CPSLO-AI-Campus-Fire-Detection/senseboard/Senseboard BOM.xlsx

Sheet: senseboard
Value | Reference | Footprint | JLCPCB Part # | Qty | MFR | PN | DNP
DNP | AE1 | Connector_Coaxial:SMA_Molex_73251-1153_EdgeMount_Horizontal | DNP | 1 | Molex | 732511153 | DNP
DNP | BT1 | Battery:BatteryHolder_Keystone_1057_1x2032 | DNP | 1 | Keystone Electronics | 1057
4.7uF | C1,C2,C5 | Capacitor_SMD:C_0805_2012Metric | C1779 | 3 | Samsung Electro-Mechanics | CL21A475KAQNNNE
10nF | C3,C23 | Capacitor_SMD:C_0402_1005Metric | C327009 | 2 | Murata Electronics | GRM155R71C103KA01D
0.1uF | C4,C8,C13,C14,C15,C16,C17,C18,C21,C22,C25,C26,C33 | Capacitor_SMD:C_0402_1005Metric | C133086 | 13 | Samsung Electro-Mechanics | CL05B104KP5NNNC
10uF | C6,C7,C34,C36 | Capacitor_SMD:C_0805_2012Metric | C1713 | 4 | Samsung Electro-Mechanics | CL21A106KOQNNNE
1uF | C9,C10,C11,C12,C24 | Capacitor_SMD:C_0603_1608Metric | C29936 | 5 | Samsung Electro-Mechanics | CL10B105KA8NNNC
4.7uF | C19,C20,C35,C37,C38 | Capacitor_SMD:C_0603_1608Metric | C1705 | 5 | Samsung Electro-Mechanics | CL10A475KP8NNNC
DNP | C27 | Capacitor_SMD:C_0603_1608Metric |  | 1 | KEMET | C0603C104K3RACTU | DNP
DNP | C28 | Capacitor_SMD:C_0805_2012Metric |  | 1 | Samsung Electro-Mechanics | CL21A475KAQNNNE | DNP
DNP | C29,C30 | Capacitor_SMD:C_0402_1005Metric |  | 2 |  |  | DNP
7pF | C31,C32 | Capacitor_SMD:C_0402_1005Metric | C161333 | 2 | Murata Electronics | GRM1555C1H7R0CA01D
STPS120MF | D1,D3 | Diode_SMD:D_SMP_DO-220AA | C2927425 | 2 | STMicroelectronics | STPS120MF
STPS1L30A | D2,D4 | Diode_SMD:D_SMA | C157388 | 2 | STMicroelectronics | STPS1L30A
LED | D5 | LED_SMD:LED_0402_1005Metric | C364556 | 1 | Lite-On Inc. | LTST-C281KRKT
BAT54WX-TP | D6,D7 | Diode_SMD:D_SOD-523 | C283259 | 2 | MCC (Micro Commercial Components) | BAT54WX-TP
Polyfuse | F1 | Fuse:Fuse_0805_2012Metric | C5220829 | 1 | Bel Fuse Inc. | 0ZCK0050FF2E
FerriteBead | FB1 | Inductor_SMD:L_0603_1608Metric | C107335 | 1 | TDK | MPZ1608S601ATA00
USB_C_Receptacle_USB2.0_16P | J1 | Connector_USB:USB_C_Receptacle_G-Switch_GT-USB-7010ASV | C2988369 | 1 | G-Switch | GT-USB-7010ASV
DNP | J2 | Connector_JST:JST_XH_B2B-XH-AM_1x02_P2.50mm_Vertical |  | 1 | JST Sales America Inc. | B2B-XH-AM | DNP
DM3AT-SF-PEJM5 | J3 | DM3AT_SF_PEJM5:HRS_DM3AT-SF-PEJM5 | C114218 | 1 | Hirose Electric Co Ltd | DM3AT-SF-PEJM5
DNP | J4 | Connector_PinHeader_2.54mm:PinHeader_1x04_P2.54mm_Vertical |  | 1 |  |  | DNP
DNP | J5 | Connector_PinHeader_2.54mm:PinHeader_1x08_P2.54mm_Vertical |  | 1 |  |  | DNP
2.2uH | L1,L2 | Inductor_SMD:L_Murata_DFE201610P | C337893 | 2 | Murata Electronics | DFE201612E-2R2M=P2
10k | R1,R9,R11,R18,R19 | Resistor_SMD:R_0402_1005Metric | C60490 | 5 | YAGEO | RC0402FR-0710KL
5.1k | R2,R3 | Resistor_SMD:R_0402_1005Metric | C278598 | 2 | Panasonic Industry | ERJ-2RKF5101X
0 | R4,R5,R6,R7,R8,R10,R20,R28,R31,R33 | Resistor_SMD:R_0402_1005Metric | C60485 | 10 | YAGEO | RC0402JR-070RL
100k | R12,R13,R14 | Resistor_SMD:R_0402_1005Metric | C60491 | 3 | YAGEO | RC0402FR-07100KL
4.7 | R16,R17 | Resistor_SMD:R_0603_1608Metric | C5549523 | 2 | YAGEO | RC0603FR-134R7L
330 | R21 | Resistor_SMD:R_0402_1005Metric | C226996 | 1 | YAGEO | AC0402FR-07330RL
47k | R22,R23,R24,R25,R26,R27 | Resistor_SMD:R_0402_1005Metric | C728561 | 6 | YAGEO | RT0402BRD0747KL
DNP | R29,R32 | Resistor_SMD:R_0402_1005Metric |  | 2 | YAGEO | RC0402JR-070RL | DNP
330 | R30 | Resistor_SMD:R_0603_1608Metric | C105881 | 1 | YAGEO | RC0603FR-07330RL
USBLC6-2SC6 | U1 | Package_TO_SOT_SMD:SOT-23-6 | C7519 | 1 | STMicroelectronics | USBLC6-2SC6
TPS62849DLCR | U2,U3 | TPS62849DLCR:VSON8_2P1X1P6_TEX | C2071003 | 2 | Texas Instruments | TPS62849DLCR
SCD41-D-R2 | U4 | Sensor:Sensirion_SCD4x-1EP_10.1x10.1mm_P1.25mm_EP4.8x4.8mm | C3659294 | 1 | Sensirion AG | SCD41-D-R2
SGP41-D-R4 | U5,U6 | SGP41-D-R4:XDCR_SGP41-D-R4 | C3659325 | 2 | Sensirion AG | SGP41-D-R4
SHT4x | U7 | Sensor_Humidity:Sensirion_DFN-4_1.5x1.5mm_P0.8mm_SHT4x_NoCentralPad | C7461863 | 1 | Sensirion AG | SHT41A-FD1B-R2
STM32L4Q5CGUx | U8 | Package_DFN_QFN:QFN-48-1EP_7x7mm_P0.5mm_EP5.6x5.6mm | C2970026 | 1 | STMicroelectronics | STM32L4P5CGU6
DNP | U9 | RF_Module:HOPERF_RFM9XW_SMD |  | 1 | RF Solutions | RFM95W-915S2 | DNP
EMIF06-MSD02N16 | U10 | EMIF06_MSD02N16:MICROQFN16_1P25X3P55X0P4_STM | C5267594 | 1 | STMicroelectronics | EMIF06-MSD02N16
BME690 | U11 | BME690:BME690 | C42431867 | 1 | Bosch Sensortec | BME690
Crystal_GND3 | Y1 | Crystal:Resonator_SMD_Murata_CSTxExxV-3Pin_3.0x1.1mm | C341520 | 1 | Murata Electronics | CSTNE12M0G550000R0
Crystal | Y2 | Crystal:Crystal_SMD_EuroQuartz_EQ161-2Pin_3.2x1.5mm | C276424 | 1 | Abracon LLC | ABS07-32.768KHZ-7-T

Sheet: Senseboard 1 r0
Reference | Qty | Value | Footprint | MPN | Datasheet Link
AE1 | 1 | Antenna_Shield |  | 732511153
BT1 | 1 | Battery_Cell |  | 1057
C1,C2,C5,C19,C20 | 5 | 4.7uF
C3,C22 | 2 | 10nF
C4 | 1 | 100nF
C6,C7 | 2 | 10uF
C8,C9,C14,C15,C16,C17,C18,C21,C24 | 9 | 0.1uF
C10,C11,C12,C13,C23 | 5 | 1uF
D1,D2,D3,D4 | 4 | PMEG1020EA |  | STPS1L30MF
F1 | 1 | Polyfuse |  | 0ZCK0050FF2E
FB1 | 1 | FerriteBead |  | MPZ1608S601ATA00
J1 | 1 | USB_C_Receptacle_USB2.0_16P |  | GT-USB-7010ASV
J2 | 1 | Micro_SD_Card_Det1 |  | DM3AT-SF-PEJM5
L1,L2 | 2 | 2.2uH |  | DFE201612E-2R2M=P2
R1,R4,R5,R6,R7,R17,R18,R19,R20,R21,R22 | 11 | 0
R2,R3,R8 | 3 | 5.1k
R9,R10,R11,R12,R15,R23,R24,R25,R26 | 9 | 10k
R13,R14 | 2 | 4.7
R16 | 1 | TBD
SW1 | 1 | SW_Push
U1 | 1 | USBLC6-2SC6 | Package_TO_SOT_SMD:SOT-23-6 | USBLC6-2SC6
U2,U3 | 2 | TPS62840DLCR | TPS62840DLCR:VSON8_2P1X1P6_TEX | TPS62849DLCR
U4 | 1 | SCD41-D-R2 | Sensor:Sensirion_SCD4x-1EP_10.1x10.1mm_P1.25mm_EP4.8x4.8mm
U5,U6 | 2 | SGP41-D-R4 | SGP41-D-R4:XDCR_SGP41-D-R4
U7 | 1 | SHT4x | Sensor_Humidity:Sensirion_DFN-4_1.5x1.5mm_P0.8mm_SHT4x_NoCentralPad
U8 | 1 | STM32L4Q5CGUx | Package_DFN_QFN:QFN-48-1EP_7x7mm_P0.5mm_EP5.6x5.6mm
U9 | 1 | RFM95W-915S2
Y1 | 1 | Crystal_GND3

Sheet: senseboard r1
Reference | Value | Datasheet | Footprint | Qty | MFR | PN | DNP
AE1 | Antenna_Shield |  | Connector_Coaxial:SMA_Molex_73251-1153_EdgeMount_Horizontal | 1 | Molex | 732511153
BT1 | CR2032 |  | Battery:BatteryHolder_Keystone_1057_1x2032 | 1 | Keystone Electronics | 1057
C1,C2,C5 | 4.7uF |  | Capacitor_SMD:C_0805_2012Metric | 3 | Samsung Electro-Mechanics | CL21A475KAQNNNE
C3,C23 | 10nF |  | Capacitor_SMD:C_0402_1005Metric | 2 | Murata Electronics | GRM155R71C103KA01D
C6,C7 | 10uF |  | Capacitor_SMD:C_0805_2012Metric | 2 | Samsung Electro-Mechanics | CL21A106KOQNNNE
C4, C8,C13,C14,C15,C16,C17,C18,C21,C22,C25,C26 | 0.1uF |  | Capacitor_SMD:C_0402_1005Metric | 12 | Samsung Electro-Mechanics | CL05B104KP5NNNC
C9,C10,C11,C12,C24 | 1uF |  | Capacitor_SMD:C_0603_1608Metric | 5 | Samsung Electro-Mechanics | CL10B105KA8NNNC
C19,C20 | 4.7uF |  | Capacitor_SMD:C_0603_1608Metric | 2 | Samsung Electro-Mechanics | CL10A475KP8NNNC
C27 | 0.1uF |  | Capacitor_SMD:C_0603_1608Metric | 1 | KEMET | C0603C104K3RACTU | DNP
C28 | 1uF |  | Capacitor_SMD:C_0805_2012Metric | 1 | Samsung Electro-Mechanics | CL21B105KAFNNNE | DNP
D1,D2,D3,D4 | PMEG1020EA |  | Diode_SMD:D_SMP_DO-220AA | 4 | STMicroelectronics | STPS1L30MF
D5 | LED |  | LED_SMD:LED_0402_1005Metric | 1 | Lite-On Inc. | LTST-C281KRKT
F1 | Polyfuse |  | Fuse:Fuse_0805_2012Metric | 1 | Bel Fuse Inc. | 0ZCK0050FF2E
FB1 | FerriteBead |  | Inductor_SMD:L_0603_1608Metric | 1 | TDK | MPZ1608S601ATA00
J1 | USB_C_Receptacle_USB2.0_16P | https://www.usb.org/sites/default/files/documents/usb_type-c.zip | Connector_USB:USB_C_Receptacle_G-Switch_GT-USB-7010ASV | 1 | G-Switch | GT-USB-7010ASV
J2 | Screw_Terminal_01x02 |  | Connector_JST:JST_XH_B2B-XH-AM_1x02_P2.50mm_Vertical | 1 |  |  | DNP
J3 | DM3AT-SF-PEJM5 |  | DM3AT_SF_PEJM5:HRS_DM3AT-SF-PEJM5 | 1 | Hirose Electric Co Ltd | DM3AT-SF-PEJM5
J4 | Conn_01x04 |  | Connector_PinHeader_2.54mm:PinHeader_1x04_P2.54mm_Vertical | 1 |  |  | DNP
J5 | Conn_01x08 |  | Connector_PinHeader_2.54mm:PinHeader_1x08_P2.54mm_Vertical | 1 |  |  | DNP
L1,L2 | 2.2uH |  | Inductor_SMD:L_Murata_DFE201610P | 2 | Murata Electronics | DFE201612E-2R2M=P2
R1,R4,R5,R6,R7,R20,R28,R29 | 0 |  | Resistor_SMD:R_0402_1005Metric | 8 | YAGEO | RC0402JR-070RL
R2,R3 | 5.1k |  | Resistor_SMD:R_0402_1005Metric | 2 | Panasonic Industry | ERJ-2RKF5101X
R9,R11,R18,R19,R21,R22,R23,R24,R25,R26,R27 | 10k |  | Resistor_SMD:R_0402_1005Metric | 11 | YAGEO | RC0402FR-0710KL
R16,R17 | 4.7 |  | Resistor_SMD:R_0603_1608Metric | 2 | YAGEO | RC0603FR-134R7L
U1 | USBLC6-2SC6 | https://www.st.com/resource/en/datasheet/usblc6-2.pdf | Package_TO_SOT_SMD:SOT-23-6 | 1 | STMicroelectronics | USBLC6-2SC6
U2,U3 | TPS62840DLCR | https://www.ti.com/lit/gpn/tps62840 | TPS62840DLCR:VSON8_2P1X1P6_TEX | 2 | Texas Instruments | TPS62849DLCR
U4 | SCD41-D-R2 | https://sensirion.com/media/documents/E0F04247/631EF271/CD_DS_SCD40_SCD41_Datasheet_D1.pdf | Sensor:Sensirion_SCD4x-1EP_10.1x10.1mm_P1.25mm_EP4.8x4.8mm | 1 | Sensirion AG | SCD41-D-R2
U5,U6 | SGP41-D-R4 |  | SGP41-D-R4:XDCR_SGP41-D-R4 | 2 | Sensirion AG | SGP41-D-R4
U7 | SHT4x | https://sensirion.com/media/documents/33FD6951/624C4357/Datasheet_SHT4x.pdf | Sensor_Humidity:Sensirion_DFN-4_1.5x1.5mm_P0.8mm_SHT4x_NoCentralPad | 1 | Sensirion AG | SHT41A-FD1B-R2
U8 | STM32L4Q5CGUx | https://www.st.com/resource/en/datasheet/stm32l4q5cg.pdf | Package_DFN_QFN:QFN-48-1EP_7x7mm_P0.5mm_EP5.6x5.6mm | 1 | STMicroelectronics | STM32L4P5CGU6
U9 | RFM95W-915S2 | https://www.hoperf.com/data/upload/portal/20181127/5bfcbea20e9ef.pdf | RF_Module:HOPERF_RFM9XW_SMD | 1 | RF Solutions | RFM95W-915S2
U10 | EMIF06-MSD02N16 | https://www.st.com/resource/en/datasheet/emif06-msd02n16.pdf | EMIF06_MSD02N16:MICROQFN16_1P25X3P55X0P4_STM | 1 | STMicroelectronics | EMIF06-MSD02N16
U11 | BME690 | https://www.bosch-sensortec.com/products/environmental-sensors/gas-sensors/bme690/#documents | BME690:BME690 | 1 | Bosch Sensortec | BME690
Y1 | Crystal_GND3 |  | Crystal:Resonator_SMD_Murata_CSTxExxV-3Pin_3.0x1.1mm | 1 | Murata Electronics | CSTNE12M0G550000R0
 | 47k |  |  |  | YAGEO | RC0402FR-0747KL
 | Batt holder |  |  |  | Keystone | 2478 (https://www.digikey.com/en/products/detail/keystone-electronics/2478/303823)
