CPSLO-AI-Campus-Fire-Detection/senseboard/senseboard.step

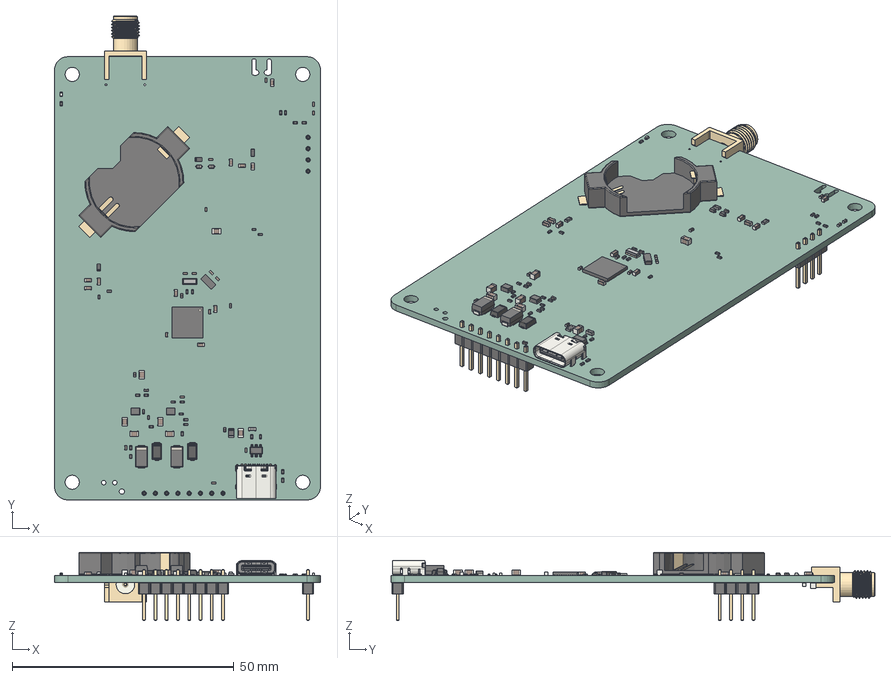
[picture p1: CAD file, 2026-10-22]
senseboard.step
60.0 x 109.2 x 15.4 mm
C_0402_1005Metric x 19
C_0603_1608Metric x 11
R_0402_1005Metric x 29
muRata_CSTxExxV
LED_0402_1005Metric
D_SOD_523 x 2
D_SMP_DO_220AA_cp x 2
R_0603_1608Metric x 3
C_0805_2012Metric x 8
USB_C_Receptacle_16P_TopMnt_Horizontal_GCT_USB4105-xx-A
Fuse_0805_2012Metric
L_Murata_DFE201610P x 2
Keystone_1058_1x2032
MicroCrystal_CC7V_T1A
QFN-48-1EP_7x7mm_Pitch0.5mm
SOT-23-6
D_SMA x 2
L_0603_1608Metric
PinHeader_1x04_P254mm_Vertical
SMA_Molex_73251-1153_EdgeMount_Horizontal
PinHeader_1x08_P254mm_Vertical
senseboard-unsaved-export-nbyW4c_PCB
