CPSLO-AI-Campus-Fire-Detection/senseboard/(list of files, cad)

Other CAD files:
.step
