CPSLO-AI-Campus-Fire-Detection/senseboard/senseboard_schematic_r1_1.pdf

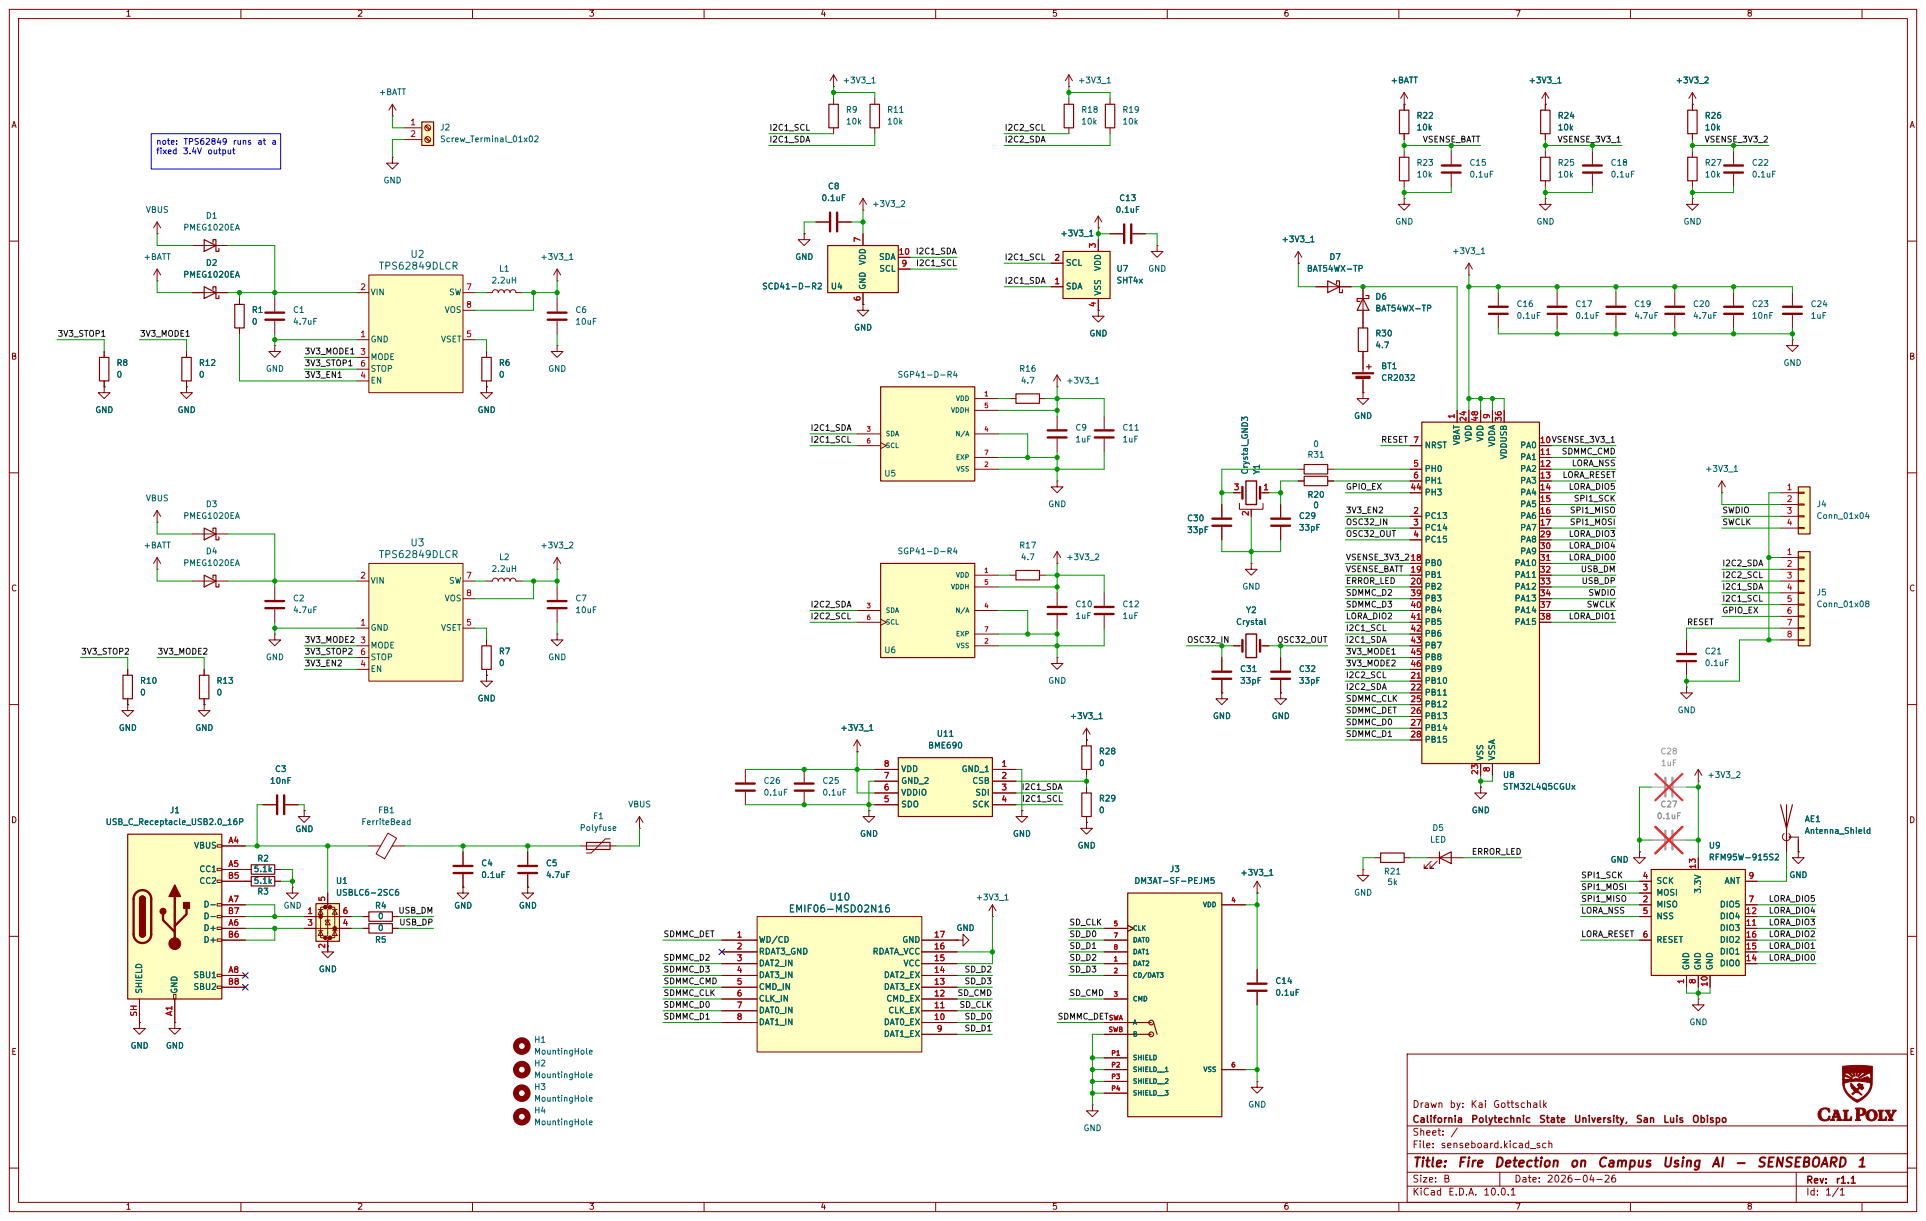
[picture p2: page 1]

Drawn by: Kai Gottschalk C5

California Polytechnic State University, San Luis Obispo
Sheet: /
File: senseboard.kicad_sch
Title: Fire Detection on Campus Using AI - SENSEBOARD 1

Size: B | Rev: r1.1
KiCad E.D.A. 10.0.1 | Id: 1/1
