CPSLO-AI-Campus-Fire-Detection/senseboard/senseboard_schematic_r1_0.pdf

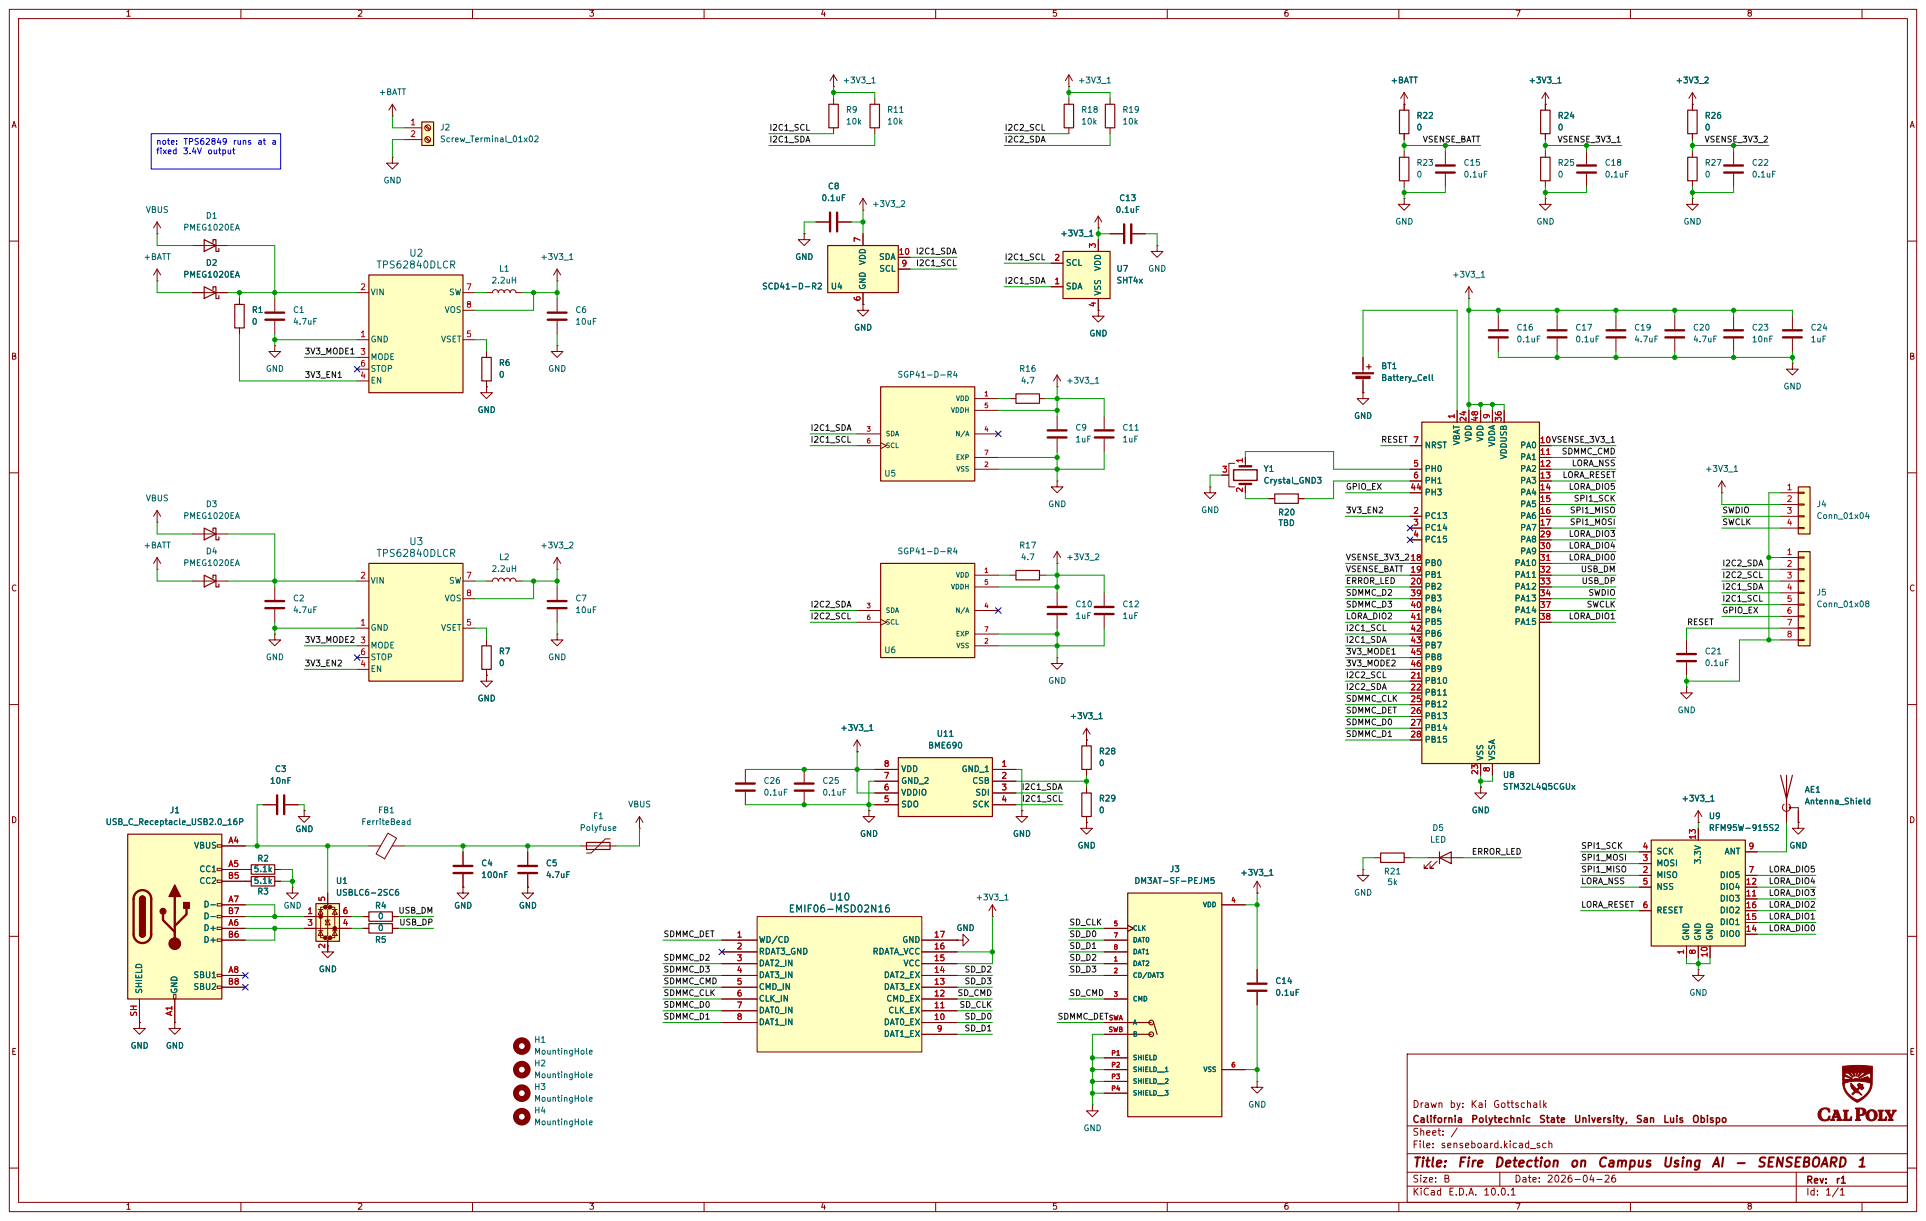
[picture p3: page 1]

Drawn by: Kai Gottschalk
California Polytechnic State University, San Luis Obispo
Sheet: /
File: senseboard.kicad_sch
Title: Fire Detection on Campus Using AI - SENSEBOARD 1

Size: B | Rev: r1
KiCad E.D.A. 10.0.1 | Id: 1/1
