CPSLO-AI-Campus-Fire-Detection/senseboard/senseboard_schematic_r0_0.pdf

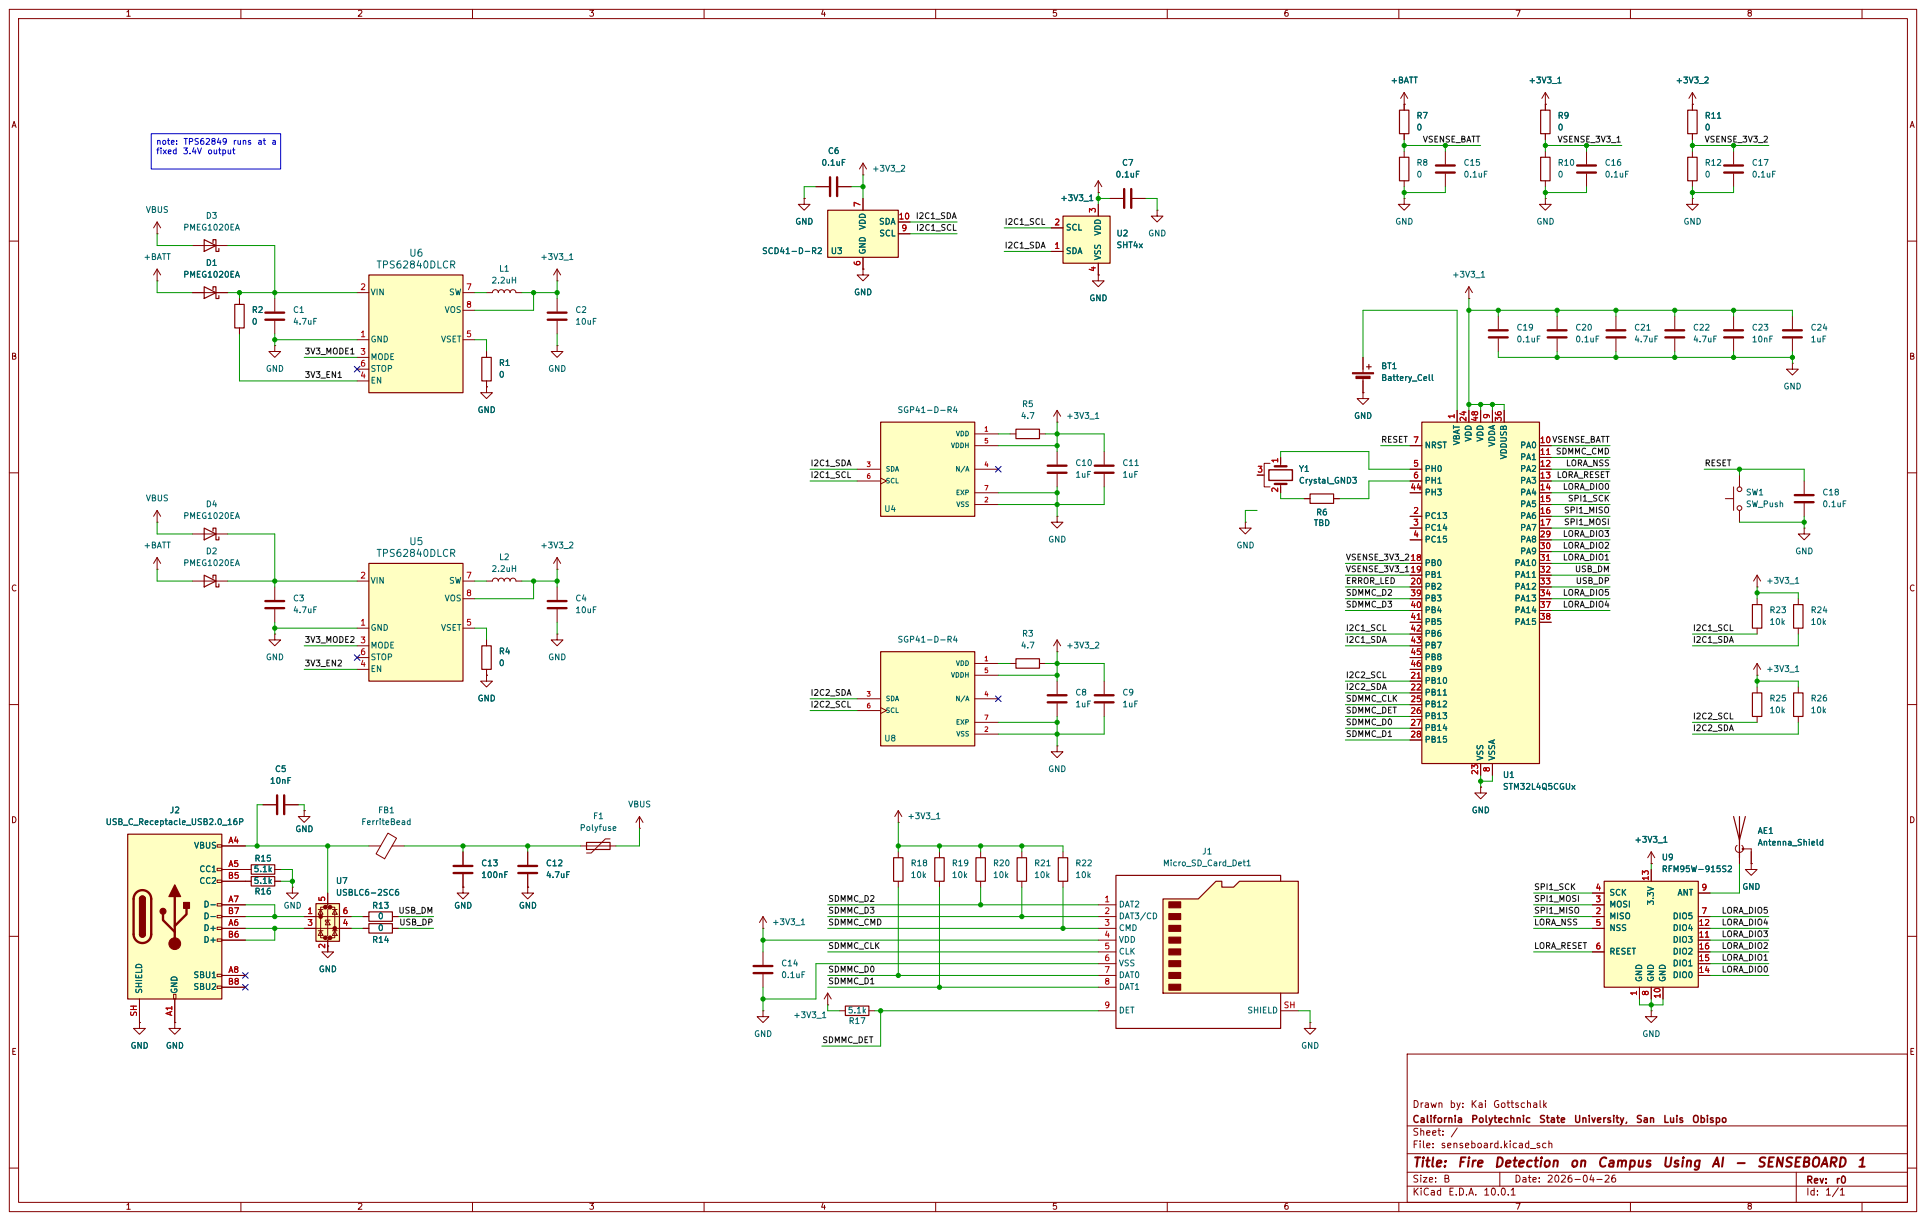
[picture p4: page 1]

RESET note: TPS62849 runs at a

VDD 4 CLK 5

SDMMC_CLK

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

Size: B | Rev: r0
KiCad E.D.A. 10.0.1 | Id: 1/1
