CPSLO-AI-Campus-Fire-Detection/senseboard/senseboard.kicad_pcb

## KiCad design senseboard.kicad_pcb (2026-10-22)

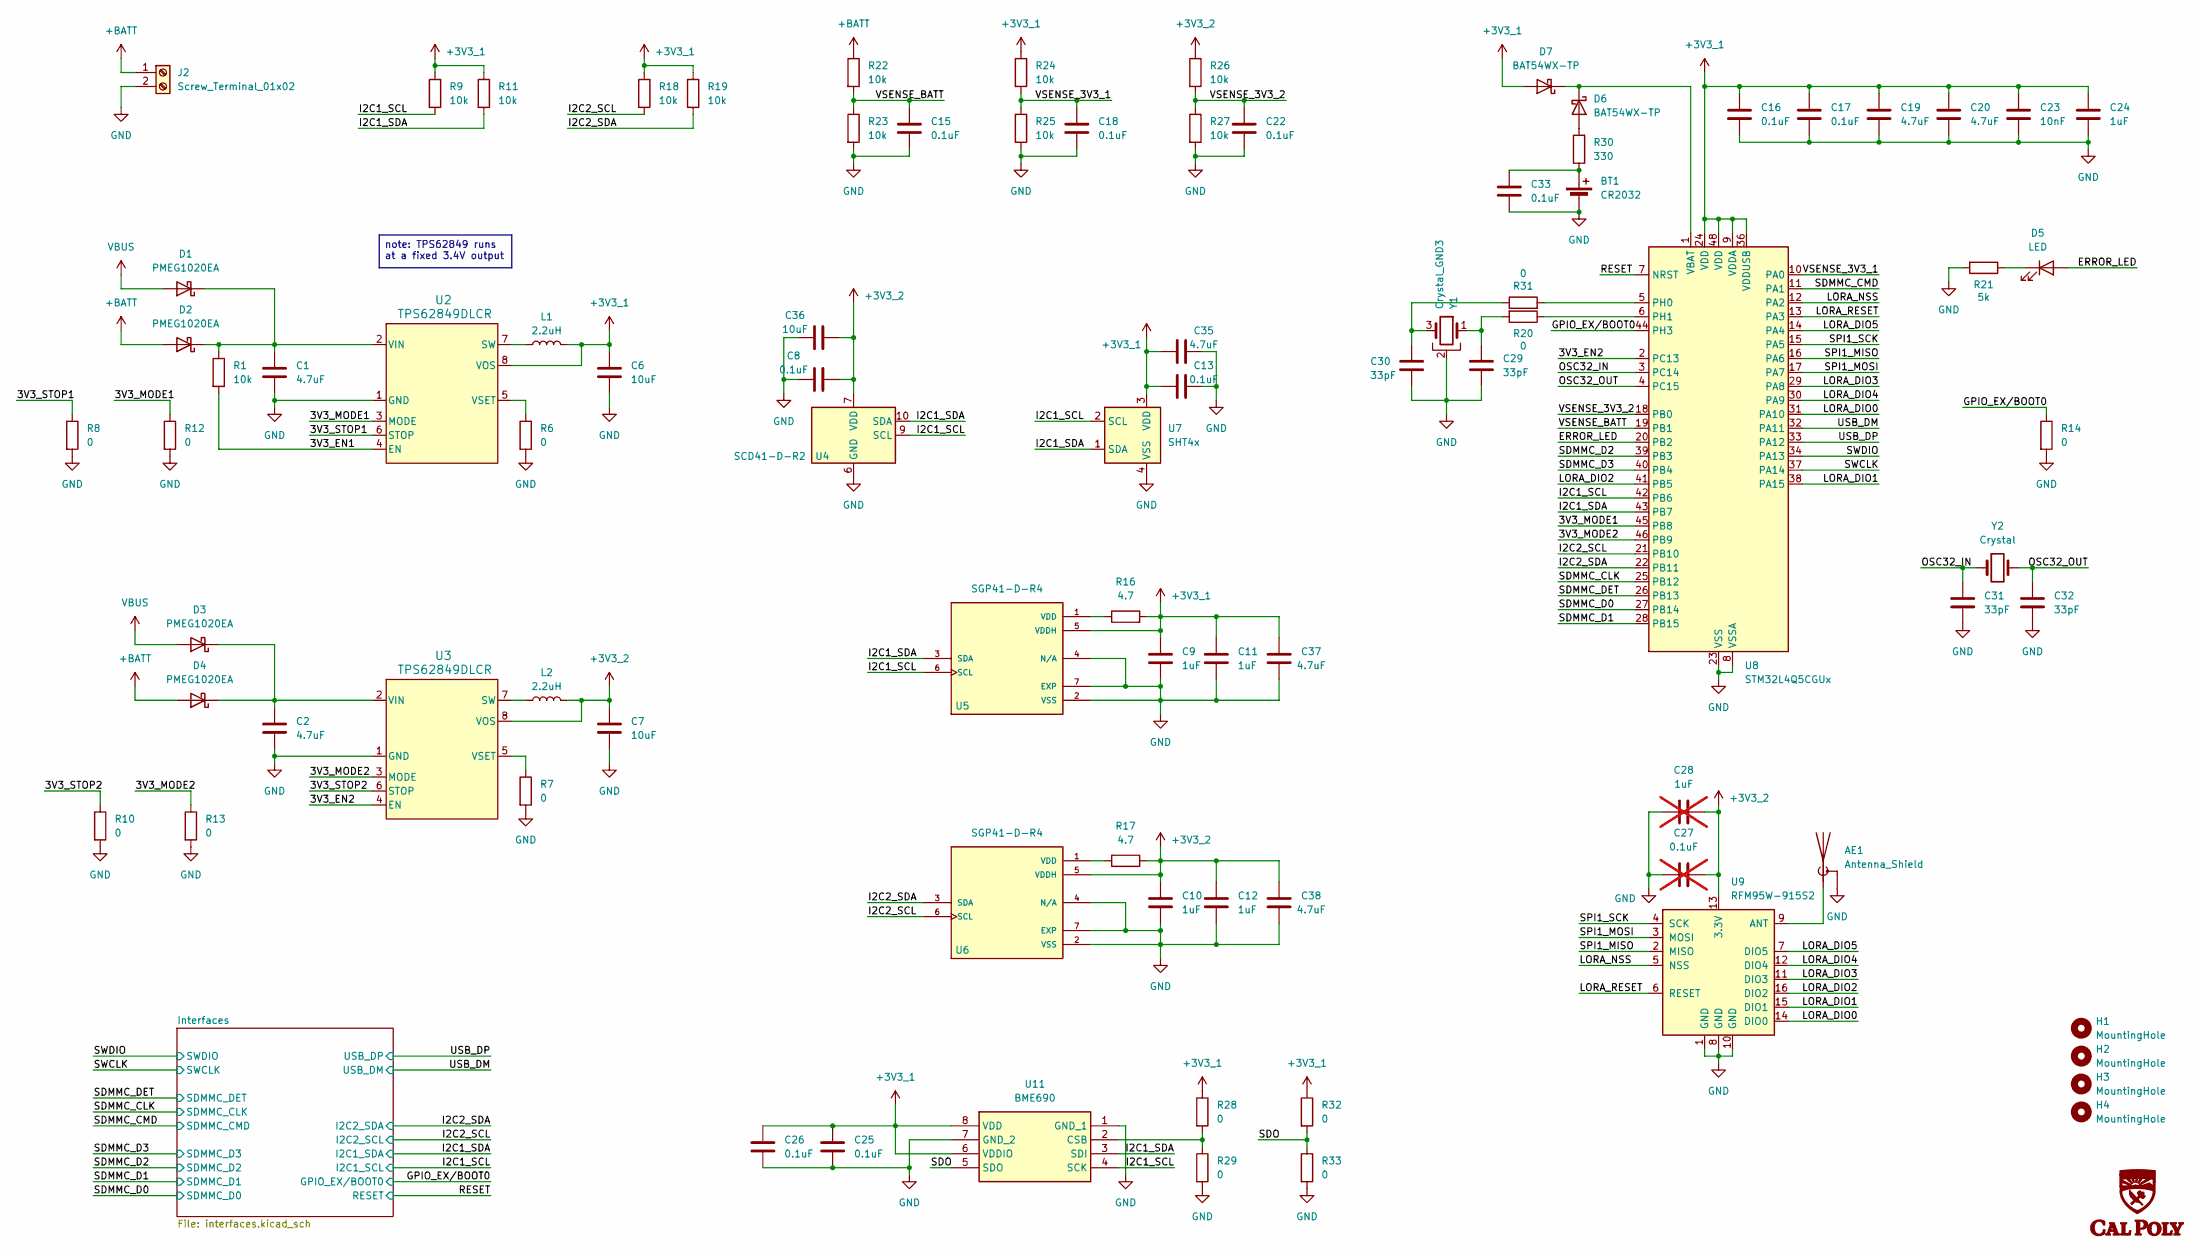
[picture p5: schematic senseboard.kicad_sch, Fire Detection on Campus Using AI - SENSEBOARD 1]

Parts:
AE1: Antenna_Shield; SMA_Molex_73251-1153_EdgeMount_Horizontal
BT1: CR2032; BatteryHolder_Keystone_1057_1x2032
C1, C2: 4.7uF; C_0805_2012Metric
C6, C7, C36: 10uF; C_0805_2012Metric
C8, C13, C15, C16, C17, C18, C22, C25, C26, C33: 0.1uF; C_0402_1005Metric
C9, C10, C11, C12, C24: 1uF; C_0603_1608Metric
C19, C20, C35, C37, C38: 4.7uF; C_0603_1608Metric
C23: 10nF; C_0402_1005Metric
C27: 0.1uF; C_0603_1608Metric; not fitted
C28: 1uF; C_0805_2012Metric; not fitted
C29, C30, C31, C32: 33pF; C_0402_1005Metric
D1, D3: PMEG1020EA; D_SMP_DO-220AA
D2, D4: PMEG1020EA; D_SMA
D5: LED; LED_0402_1005Metric
D6, D7: BAT54WX-TP; D_SOD-523
H1, H2, H3, H4: MountingHole; MountingHole_3.2mm_M3_ISO7380
J2: Screw_Terminal_01x02; JST_XH_B2B-XH-AM_1x02_P2.50mm_Vertical
L1, L2: 2.2uH; L_Murata_DFE201610P
R1, R9, R11, R18, R19, R22, R23, R24, R25, R26, R27: 10k; R_0402_1005Metric
R6, R7, R8, R10, R12, R13, R14, R20, R28, R29, R31, R32, R33: 0; R_0402_1005Metric
R16, R17: 4.7; R_0603_1608Metric
R21: 5k; R_0402_1005Metric
R30: 330; R_0603_1608Metric
U2, U3: TPS62849DLCR; VSON8_2P1X1P6_TEX
U4: SCD41-D-R2; Sensirion_SCD4x-1EP_10.1x10.1mm_P1.25mm_EP4.8x4.8mm
U5, U6: SGP41-D-R4; XDCR_SGP41-D-R4; PARTREV 1.0
U7: SHT4x; Sensirion_DFN-4_1.5x1.5mm_P0.8mm_SHT4x_NoCentralPad
U8: STM32L4Q5CGUx; QFN-48-1EP_7x7mm_P0.5mm_EP5.6x5.6mm
U9: RFM95W-915S2; HOPERF_RFM9XW_SMD
U11: BME690; Mouser Part Number 262-BME690
Y1: Crystal_GND3; Resonator_SMD_Murata_CSTxExxV-3Pin_3.0x1.1mm
Y2: Crystal; Crystal_SMD_EuroQuartz_EQ161-2Pin_3.2x1.5mm

Connections:
+3V3_1: C6.1, C9.2, C11.2, C13.2, C16.2, C17.2, C19.2, C20.2, C23.2, C24.2, C25.1, C26.1, C35.2, C37.1, D7.2 (A), L1.2, R9.1, R11.1, R16.2, R18.1, R19.1, R24.1, R28.1, R32.1, U2.8 (VOS), U5.5 (VDDH), U7.3 (VDD), U8.9 (VDDA), U8.24 (VDD), U8.36 (VDDUSB), U8.48 (VDD), U11.6 (VDDIO), U11.8 (VDD); also elsewhere on the board
+3V3_2: C7.1, C8.2, C10.2, C12.2, C27.1, C28.1, C36.2, C38.1, L2.2, R17.2, R26.1, U3.8 (VOS), U4.7 (VDD), U4.19 (VDD), U6.5 (VDDH), U9.13 (3.3V)
+BATT: D2.2 (A), D4.2 (A), J2.1, R22.1
/3V3_EN1: R1.2, U2.4 (EN)
/3V3_EN2: U3.4 (EN), U8.2 (PC13)
/3V3_MODE1: R12.1, U2.3 (MODE), U8.45 (PB8)
/3V3_MODE2: R13.1, U3.3 (MODE), U8.46 (PB9)
/3V3_STOP1: R8.1, U2.6 (STOP)
/3V3_STOP2: R10.1, U3.6 (STOP)
/ERROR_LED: D5.2 (A), U8.20 (PB2)
/GPIO_EX/BOOT0: R14.1, U8.44 (PH3); also elsewhere on the board
/I2C1_SCL: R9.2, U4.9 (SCL), U5.6 (SCL), U7.2 (SCL), U8.42 (PB6), U11.4 (SCK); also elsewhere on the board
/I2C1_SDA: R11.2, U4.10 (SDA), U5.3 (SDA), U7.1 (SDA), U8.43 (PB7), U11.3 (SDI); also elsewhere on the board
/I2C2_SCL: R18.2, U6.6 (SCL), U8.21 (PB10); also elsewhere on the board
/I2C2_SDA: R19.2, U6.3 (SDA), U8.22 (PB11); also elsewhere on the board
/LORA_DIO0: U8.31 (PA10), U9.14 (DIO0)
/LORA_DIO1: U8.38 (PA15), U9.15 (DIO1)
/LORA_DIO2: U8.41 (PB5), U9.16 (DIO2)
/LORA_DIO3: U8.29 (PA8), U9.11 (DIO3)
/LORA_DIO4: U8.30 (PA9), U9.12 (DIO4)
/LORA_DIO5: U8.14 (PA4), U9.7 (DIO5)
/LORA_NSS: U8.12 (PA2), U9.5 (NSS)
/LORA_RESET: U8.13 (PA3), U9.6 (RESET)
/OSC32_IN: C31.1, U8.3 (PC14), Y2.1
/OSC32_OUT: C32.1, U8.4 (PC15), Y2.2
/RESET: U8.7 (NRST); also elsewhere on the board
/SDMMC_CLK: U8.25 (PB12); also elsewhere on the board
/SDMMC_CMD: U8.11 (PA1); also elsewhere on the board
/SDMMC_D0: U8.27 (PB14); also elsewhere on the board
/SDMMC_D1: U8.28 (PB15); also elsewhere on the board
/SDMMC_D2: U8.39 (PB3); also elsewhere on the board
/SDMMC_D3: U8.40 (PB4); also elsewhere on the board
/SDMMC_DET: U8.26 (PB13); also elsewhere on the board
/SDO: R32.2, R33.1, U11.5 (SDO)
/SPI1_MISO: U8.16 (PA6), U9.2 (MISO)
/SPI1_MOSI: U8.17 (PA7), U9.3 (MOSI)
/SPI1_SCK: U8.15 (PA5), U9.4 (SCK)
/SWCLK: U8.37 (PA14); also elsewhere on the board
/SWDIO: U8.34 (PA13); also elsewhere on the board
/USB_DM: U8.32 (PA11); also elsewhere on the board
/USB_DP: U8.33 (PA12); also elsewhere on the board
/VSENSE_3V3_1: C18.1, R24.2, R25.1, U8.10 (PA0)
/VSENSE_3V3_2: C22.1, R26.2, R27.1, U8.18 (PB0)
/VSENSE_BATT: C15.1, R22.2, R23.1, U8.19 (PB1)
GND: AE1.2 (Shield), BT1.2 (-), C1.2, C2.2, C6.2, C7.2, C8.1, C9.1, C10.1, C11.1, C12.1, C13.1, C15.2, C16.1, C17.1, C18.2, C19.1, C20.1, C22.2, C23.1, C24.1, C25.2, C26.2, C27.2, C28.2, C29.2, C30.1, C31.2, C32.2, C33.1, C35.1, C36.1, C37.2, C38.2, J2.2, R6.2, R7.2, R8.2, R10.2, R12.2, R13.2, R14.2, R21.2, R23.2, R25.2, R27.2, R29.2, R33.2, U2.1 (GND), U3.1 (GND), U4.6 (GND), U4.20 (GND), U4.21 (GND), U5.2 (VSS), U5.4 (N/A), U5.7 (EXP), U6.2 (VSS), U6.4 (N/A), U6.7 (EXP), U7.4 (VSS), U8.8 (VSSA), U8.23 (VSS), U8.35 (VSS), U8.47 (VSS), U8.49 (VSS), U9.1 (GND), U9.8 (GND), U9.10 (GND), U11.1 (GND_1), U11.7 (GND_2), Y1.2; also elsewhere on the board
unnamed: AE1.1 (A), U9.9 (ANT)
unnamed: BT1.1 (+), C33.2, R30.1
unnamed: C29.1, R20.2, Y1.1
unnamed: C30.2, R31.1, Y1.3
unnamed: C1.1, D1.1 (K), D2.1 (K), R1.1, U2.2 (VIN)
unnamed: C2.1, D3.1 (K), D4.1 (K), U3.2 (VIN)
unnamed: D5.1 (K), R21.1
unnamed: D6.2 (A), R30.2
unnamed: D6.1 (K), D7.1 (K), U8.1 (VBAT)
unnamed: L1.1, U2.7 (SW)
unnamed: R6.1, U2.5 (VSET)
unnamed: L2.1, U3.7 (SW)
unnamed: R7.1, U3.5 (VSET)
unnamed: R16.1, U5.1 (VDD)
unnamed: R17.1, U6.1 (VDD)
unnamed: R31.2, U8.5 (PH0)
unnamed: R20.1, U8.6 (PH1)
unnamed: R28.2, R29.1, U11.2 (CSB)
VBUS: D1.2 (A), D3.2 (A); also elsewhere on the board

Notes on the sheet:
note: TPS62849 runs at a fixed 3.4V output

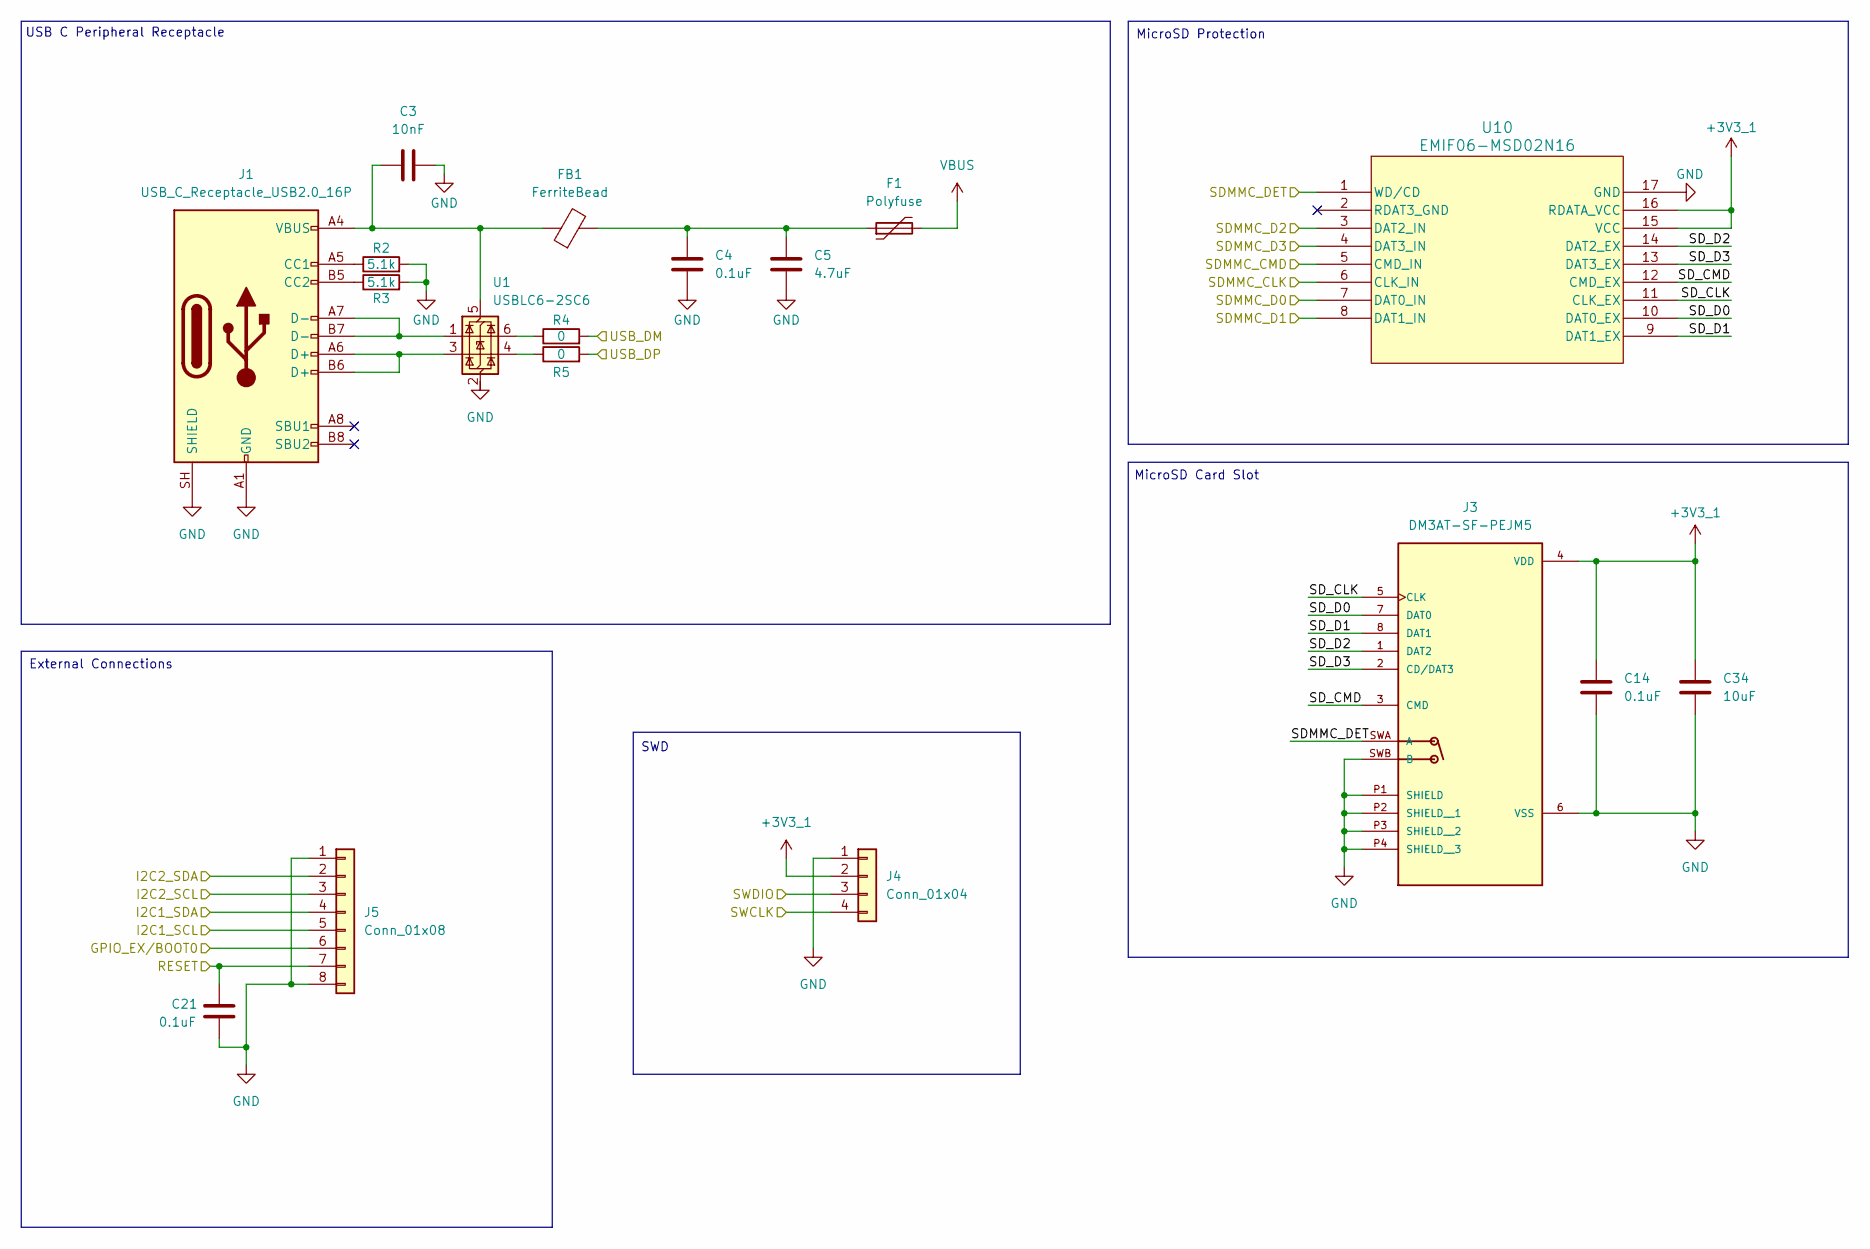
[picture p6: schematic interfaces.kicad_sch]

Parts:
C3: 10nF; C_0402_1005Metric
C4, C14, C21: 0.1uF; C_0402_1005Metric
C5: 4.7uF; C_0805_2012Metric
C34: 10uF; C_0805_2012Metric
F1: Polyfuse; Fuse_0805_2012Metric
FB1: FerriteBead; L_0603_1608Metric
J1: USB_C_Receptacle_USB2.0_16P; USB_C_Receptacle_G-Switch_GT-USB-7010ASV
J3: DM3AT-SF-PEJM5; HRS_DM3AT-SF-PEJM5; PARTREV 20200913
J4: Conn_01x04; PinHeader_1x04_P2.54mm_Vertical
J5: Conn_01x08; PinHeader_1x08_P2.54mm_Vertical
R2, R3: 5.1k; R_0402_1005Metric
R4, R5: 0; R_0402_1005Metric
U1: USBLC6-2SC6; SOT-23-6
U10: EMIF06-MSD02N16; MICROQFN16_1P25X3P55X0P4_STM

Connections:
+3V3_1: C14.1, C34.1, J3.4 (VDD), J4.2, U10.15 (VCC), U10.16 (RDATA_VCC); also elsewhere on the board
/GPIO_EX/BOOT0: J5.6; also elsewhere on the board
/I2C1_SCL: J5.5; also elsewhere on the board
/I2C1_SDA: J5.4; also elsewhere on the board
/I2C2_SCL: J5.3; also elsewhere on the board
/I2C2_SDA: J5.2; also elsewhere on the board
/Interfaces/SD_CLK: J3.5 (CLK), U10.11 (CLK_EX)
/Interfaces/SD_CMD: J3.3 (CMD), U10.12 (CMD_EX)
/Interfaces/SD_D0: J3.7 (DAT0), U10.10 (DAT0_EX)
/Interfaces/SD_D1: J3.8 (DAT1), U10.9 (DAT1_EX)
/Interfaces/SD_D2: J3.1 (DAT2), U10.14 (DAT2_EX)
/Interfaces/SD_D3: J3.2 (CD/DAT3), U10.13 (DAT3_EX)
/RESET: C21.1, J5.7; also elsewhere on the board
/SDMMC_CLK: U10.6 (CLK_IN); also elsewhere on the board
/SDMMC_CMD: U10.5 (CMD_IN); also elsewhere on the board
/SDMMC_D0: U10.7 (DAT0_IN); also elsewhere on the board
/SDMMC_D1: U10.8 (DAT1_IN); also elsewhere on the board
/SDMMC_D2: U10.3 (DAT2_IN); also elsewhere on the board
/SDMMC_D3: U10.4 (DAT3_IN); also elsewhere on the board
/SDMMC_DET: J3.SWA (A), U10.1 (WD/CD); also elsewhere on the board
/SWCLK: J4.4; also elsewhere on the board
/SWDIO: J4.3; also elsewhere on the board
/USB_DM: R4.2; also elsewhere on the board
/USB_DP: R5.2; also elsewhere on the board
GND: C3.2, C4.1, C5.1, C14.2, C21.2, C34.2, J1.A1 (GND), J1.A12 (GND), J1.B1 (GND), J1.B12 (GND), J1.SH (SHIELD), J3.6 (VSS), J3.P1 (SHIELD), J3.P2 (SHIELD__1), J3.P3 (SHIELD__2), J3.P4 (SHIELD__3), J3.SWB (B), J4.1, J5.1, J5.8, R2.2, R3.2, U10.17 (GND); also elsewhere on the board
unnamed: C4.2, C5.2, F1.1, FB1.2
unnamed: J1.A5 (CC1), R2.1
unnamed: J1.B5 (CC2), R3.1
unnamed: J1.A6 (D+), J1.B6 (D+), U1.3 (I/O2)
unnamed: J1.A7 (D-), J1.B7 (D-), U1.1 (I/O1)
unnamed: R4.1, U1.6 (I/O1)
unnamed: R5.1, U1.4 (I/O2)
unnamed: C3.1, FB1.1, J1.A4 (VBUS), J1.A9 (VBUS), J1.B4 (VBUS), J1.B9 (VBUS), U1.5 (VBUS)
VBUS: F1.2; also elsewhere on the board

Notes on the sheet:
External Connections
SWD
MicroSD Card Slot
MicroSD Protection
USB C Peripheral Receptacle

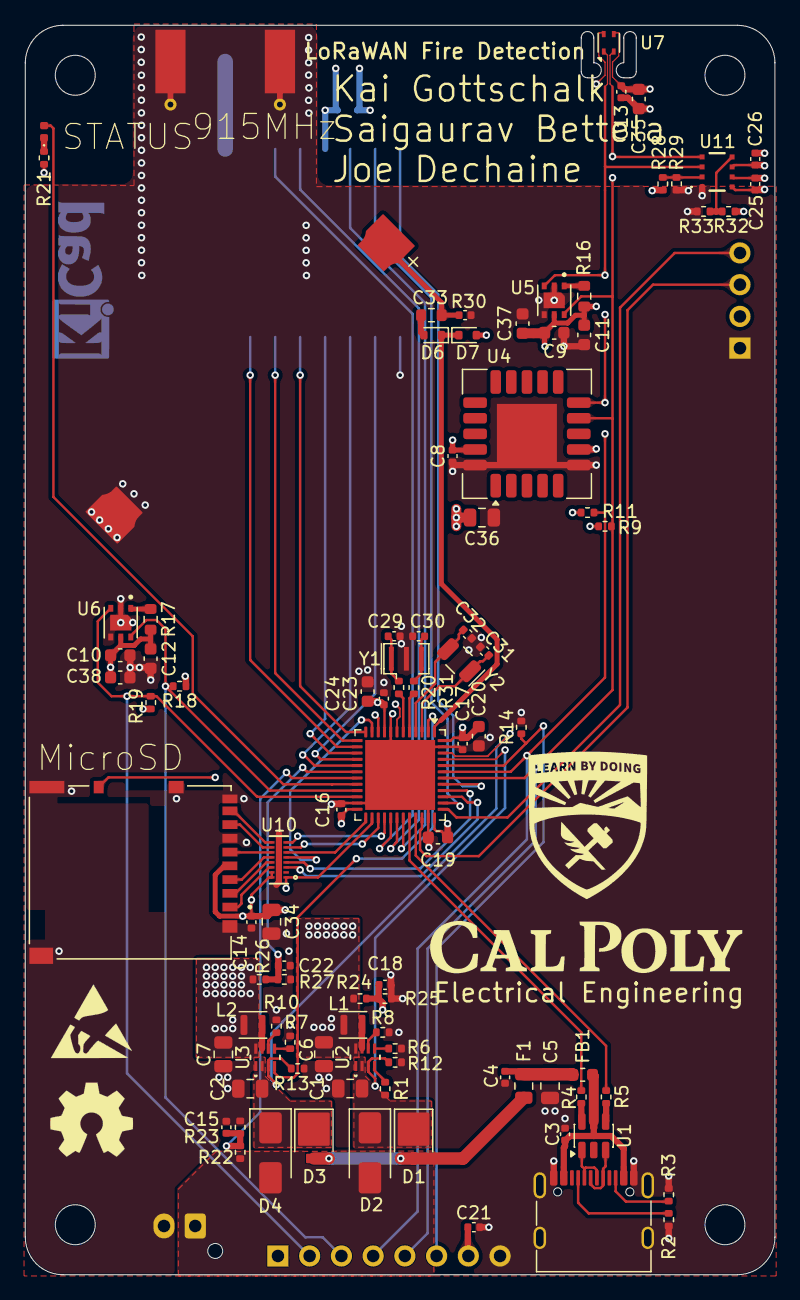
[picture p7: board senseboard.kicad_pcb from above]

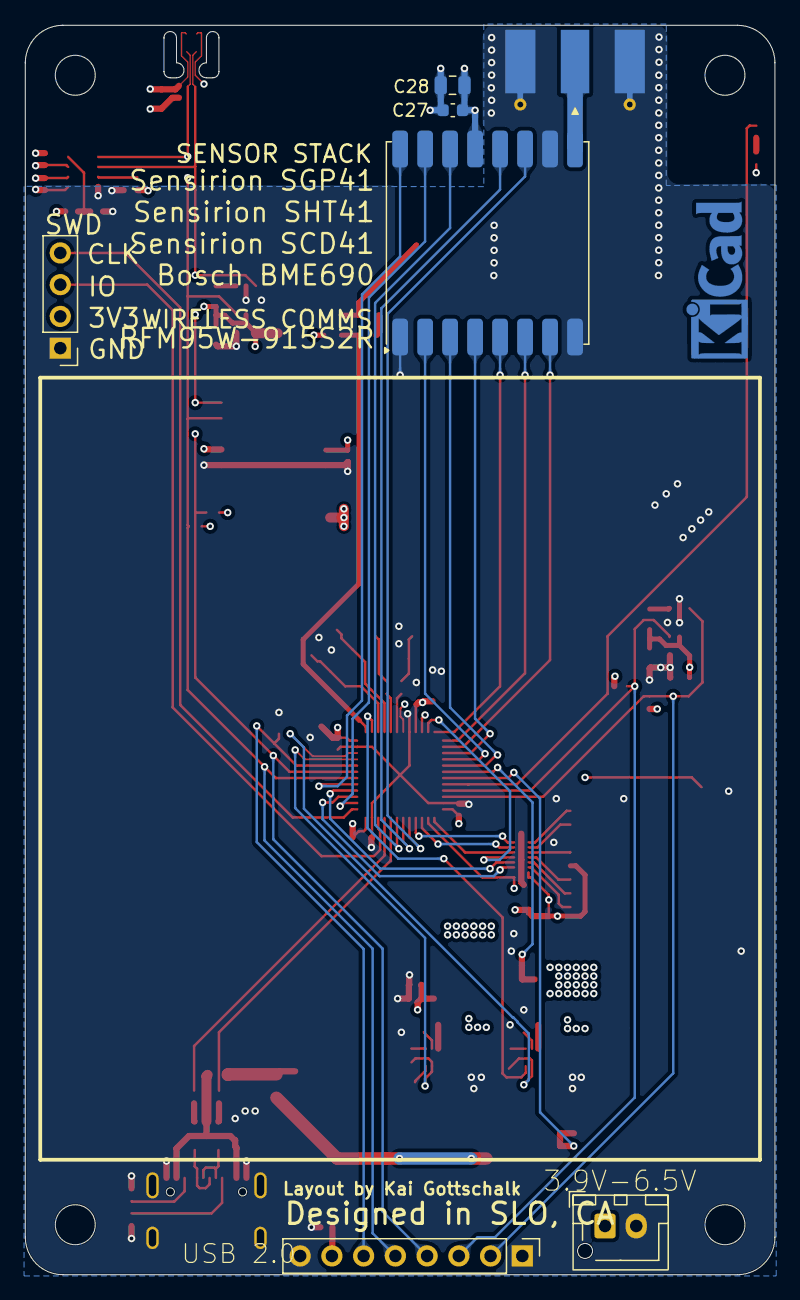
[picture p8: board senseboard.kicad_pcb from below]

Board: 6 copper layers, 60.0 x 100.0 mm, 105 parts (7 on the bottom side), 78 nets.
