CPSLO-AI-Campus-Fire-Detection/senseboard/(commit log)

2026-04-20 created project and added initial ICs in schematic design
    [senseboard.kicad_pcb, senseboard.kicad_sch]
2026-04-25 added updated regulators, power domains
    [senseboard.kicad_sch]
2026-04-27 changed sheet size, added redundant sgp and worked to set up power domains further
    [senseboard.kicad_sch]
2026-04-29 added LORA module, sd card, usb c filtering, stm32 neccesary reset/clocks and added ADC dividers and i2c pull ups
    [senseboard.kicad_sch]
2026-04-29 adjusted file structure for kicad 10
    [senseboard.kicad_pcb, senseboard.kicad_sch]
2026-04-29 added initial bom
    [senseboard.csv, senseboard.kicad_sch]
2026-04-30 fixed gnd positioning and added error led
    [senseboard.kicad_sch]
2026-05-02 minor changes to schematic, modified sd card holder and added all footprint references, began layout of board
    [senseboard.kicad_pcb, senseboard.kicad_sch]
2026-05-03 added sd card protection, completed most layout, added bosch sensor, graphics
    [senseboard.kicad_pcb, senseboard.kicad_sch]
2026-05-03 connected n/a on sgp41 to gnd
    [senseboard.kicad_pcb, senseboard.kicad_sch]
2026-05-03 added values and variant for assembly, added 3d model for sd protection to layout, played with via setup
    [senseboard.kicad_pcb, senseboard.kicad_sch]
2026-05-05 added blocking protection for coin cell and charge limiting
    [senseboard.csv, senseboard.kicad_pcb, senseboard.kicad_sch]
2026-05-06 added lots of additional resistors and caps for added decoupling and modification if neccesary, finalized layout and added graphics
    [senseboard.kicad_pcb, senseboard.kicad_sch]
2026-05-06 final layout mods and added a couple more bulk caps
    [senseboard.kicad_pcb, senseboard.kicad_sch]
2026-05-06 finalized schematic placement and exported updated BOM, changed 50k to 47k
    [senseboard.csv, senseboard.kicad_sch]
2026-05-07 added first turn of gerbers and drill files, added boms and placement files
    [Senseboard BOM.xlsx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]
2026-05-17 final turn gerbers
2026-10-22 cleaned schematic for interview
2026-10-22 added updated step with components and traces
